MikyM0use/OLED-scanner/(threads)

Thread 1 (2016-09-19):

video out consistent through entire channel range

thedreygen, 2016-09-19:
Hi, I did this modification on my rc305 using all of the same hardware as you did. Thanks for your work and for the great info!

I am having an issue with my video output; it isn't coming through clearly. I have tried with both a 25mw and 200mw video transmitter and set the OLEDrx to the same channel, but the image is coming through like it isn't "locked" onto a channel. I'm thinking it may be stuck in scan mode and not changing to rx... not sure as I am not very great at arduino coding, but I am getting better :)

Unfortunately I do not have a DVR, but I snapped a few pictures of my quanums. I'd appreciate any help if you have a clue as to what may be going on.
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
PS - I know that I need to adjust the voltage divider but that isn't on the top of my list right now :)
Thanks!

Thread 2 (2017-06-10):

Battery calibration

andredavanz, 2017-06-10:
Hi! I've connected 1s battery tu a usb step-up converter to provide 5v to the circuit, but the battery voltage displayed is a little too high for my lipo (it shows 4,43V , it should be now around 4V). can you please add a method to "offset" the battery displayed voltage up and down a little? it would help me with this problem and it should be easy enough.

Thank you :)
