MikyM0use/OLED-scanner/src/oled_scanner_sketch/oled_scanner_sketch.ino

/*
This file is part of OLED 5.8ghz Scanner project.

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
    Copyright © 2016 Michele Martinelli
  */

#include <SPI.h>
#include <Wire.h>
#include <EEPROM.h>
#include "U8glib.h"
#include "rx5808.h"
#include "const.h"

// devices with all constructor calls is here: http://code.google.com/p/u8glib/wiki/device
U8GLIB_SSD1306_128X64 u8g(U8G_I2C_OPT_DEV_0 | U8G_I2C_OPT_NO_ACK | U8G_I2C_OPT_FAST); // Fast I2C / TWI

RX5808 rx5808(rssi_pin);

byte data0 = 0;
byte data1 = 0;
byte data2 = 0;
byte data3 = 0;

#define SCANNER_MODE 0
#define RECEIVER_MODE 1

uint8_t curr_status = SCANNER_MODE;
uint8_t curr_screen = 6;
uint8_t curr_channel = 0;
uint32_t curr_freq;

//battery monitor
float volt;
uint16_t VoltDivider = 10.5;

uint32_t last_irq;
uint8_t changing_freq, changing_mode;

//default values used for calibration
uint16_t rssi_min = 1024;
uint16_t rssi_max = 0;

void irq_select_handle() {
  if (millis() - last_irq < 500) //debounce
    return;

  if (curr_status == SCANNER_MODE && digitalRead(button_select) == LOW) { //simply switch to the next screen
    curr_screen = (curr_screen + 1) % 7;
  }

  if (curr_status == RECEIVER_MODE) {
    if (digitalRead(button_select) == HIGH && millis() - last_irq > 800) //long press to reach the next strong cannel
      curr_channel = rx5808.getNext(curr_channel);
    else
      curr_channel = (curr_channel + 1) % CHANNEL_MAX;

    changing_freq = 1;
  }

  rx5808.abortScan();
  last_irq = millis();
}

void irq_mode_handle() {
  if (millis() - last_irq < 500) //debounce
    return;

  if (digitalRead(button_mode) == LOW) {
    rx5808.abortScan();
    changing_mode = 1;

    if (curr_status == RECEIVER_MODE) {
      curr_status = SCANNER_MODE;
    } else {
      curr_status = RECEIVER_MODE;
      curr_channel = rx5808.getMaxPos(); //next channel is the strongest
    }
  }
  last_irq = millis();
}

void setup() {
  //button init
  pinMode(button_select, INPUT);
  digitalWrite(button_select, HIGH);
  pinMode(button_mode, INPUT);
  digitalWrite(button_mode, HIGH);

  //display init
  // assign default color value
  if ( u8g.getMode() == U8G_MODE_R3G3B2 ) {
    u8g.setColorIndex(255);     // white
  }
  else if ( u8g.getMode() == U8G_MODE_GRAY2BIT ) {
    u8g.setColorIndex(3);         // max intensity
  }
  else if ( u8g.getMode() == U8G_MODE_BW ) {
    u8g.setColorIndex(1);         // pixel on
  }
  else if ( u8g.getMode() == U8G_MODE_HICOLOR ) {
    u8g.setHiColorByRGB(255, 255, 255);
  }

  u8g.setDefaultForegroundColor();
  splashScr();

  // initialize SPI:
  pinMode (SSP, OUTPUT);
  SPI.begin();
  SPI.setBitOrder(LSBFIRST);
  rx5808.init();

  //power on calibration if button pressed
  while (digitalRead(button_select) == LOW || digitalRead(button_mode) == LOW) {
    rx5808.calibration();
  }

  //receiver init
  curr_channel = rx5808.getMaxPos();
  changing_freq = 1;
  changing_mode = 0;

  //rock&roll
  attachInterrupt(digitalPinToInterrupt(button_select), irq_select_handle, CHANGE);
  attachInterrupt(digitalPinToInterrupt(button_mode), irq_mode_handle, CHANGE);
}

void loop(void) {
  battery_measure();

  if (curr_status == SCANNER_MODE) {
    rx5808.scan(1, BIN_H);
  }

  u8g.firstPage();
  do {
    if (changing_mode) { //if changing mode "please wait..."
      wait_draw();
    } else {
      if (curr_status == RECEIVER_MODE) {
        receiver_draw(curr_channel);
      }
      if (curr_status == SCANNER_MODE) {
        scanner_draw(curr_screen);
      }
    }
  } while ( u8g.nextPage() );

  if (curr_status == RECEIVER_MODE && changing_freq || changing_mode) {
    changing_freq = changing_mode = 0;
    rx5808.scan(1, BIN_H);
    curr_freq = pgm_read_word_near(channelFreqTable + curr_channel);
    rx5808.setFreq(curr_freq);
  }
}
