MikyM0use/OLED-scanner/src/oled_scanner_sketch/rx5808.ino

/*
This file is part of OLED 5.8ghz Scanner project.

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
    Copyright © 2016 Michele Martinelli
  */

#include "rx5808.h"
#define RSSI_THRESH (scanVec[getMaxPos()]-5) //strong channels are near to the global max

RX5808::RX5808(uint16_t pin) {
  _rssiPin = pin;
  _stop_scan = 0;
}

uint16_t RX5808::getRssi(uint16_t channel) {
  return scanVec[channel];
}

//stop scan
void RX5808::abortScan(void) {
  _stop_scan = 1;
}
//get next strong rssi channel
uint16_t RX5808::getNext(uint16_t channel) {
  channel = (channel + 1) % CHANNEL_MAX;
  for (uint16_t  complete_iter = CHANNEL_MAX - CHANNEL_MIN; complete_iter != 0; complete_iter-- ) {
    if (scanVec[channel] > RSSI_THRESH) //new over threashold
      return channel;
    channel = (channel + 1) % CHANNEL_MAX;
  }

  return channel;
}

//get the rssi value of a certain channel of a band and map it to 1...norm
uint16_t RX5808::getVal(uint16_t band, uint16_t channel, uint8_t norm) {
  return map(scanVec[8 * band + channel], 1, 40, 1, norm);
}

//get the maximum rssi value for a certain band
uint16_t RX5808::getMaxPosBand(uint8_t band) {
  uint16_t _chan;
  uint16_t maxVal = 0, maxPos = 8 * band;
  for (_chan = 8 * band; _chan < 8 * band + 8; _chan++) {
    if (maxVal < scanVec[_chan]) { //new max
      maxPos = _chan;
      maxVal = scanVec[_chan];

    }
  }
  return maxPos;
}

//get the minimum rssi value for a certain band
uint16_t RX5808::getMinPosBand(uint8_t band) {
  uint16_t _chan;
  uint16_t minVal = 1000, minPos = 8 * band;
  for (_chan = 8 * band; _chan < 8 * band + 8; _chan++) {
    if (minVal > scanVec[_chan]) { //new max
      minPos = _chan;
      minVal = scanVec[_chan];

    }
  }
  return minPos;
}

//get global max
uint16_t RX5808::getMaxPos() {
  uint8_t _chan;
  uint16_t maxVal = 0, maxPos = 0;
  for (_chan = CHANNEL_MIN; _chan < CHANNEL_MAX; _chan++) {
    if (maxVal < scanVec[_chan]) { //new max
      maxPos = _chan;
      maxVal = scanVec[_chan];

    }
  }
  return maxPos;
}

//get global min
uint16_t RX5808::getMinPos() {
  uint8_t _chan;
  uint16_t minVal = 1000, minPos = 0;
  for (_chan = CHANNEL_MIN; _chan < CHANNEL_MAX; _chan++) {
    if (minVal > scanVec[_chan]) { //new max
      minPos = _chan;
      minVal = scanVec[_chan];

    }
  }
  return minPos;
}

void RX5808::init() {
  rssi_min = ((EEPROM.read(EEPROM_ADR_RSSI_MIN_H) << 8) | (EEPROM.read(EEPROM_ADR_RSSI_MIN_L)));
  rssi_max = ((EEPROM.read(EEPROM_ADR_RSSI_MAX_H) << 8) | (EEPROM.read(EEPROM_ADR_RSSI_MAX_L)));

  digitalWrite(SSP, LOW);
  SPI.transfer(0x10);
  SPI.transfer(0x01);
  SPI.transfer(0x00);
  SPI.transfer(0x00);
  digitalWrite(SSP, HIGH);

  rx5808.scan(1, BIN_H);
}

//set a certain frequency for the RX module
void RX5808::setFreq(uint32_t freq) {
  uint32_t Delitel = (freq - 479) / 2;

  byte DelitelH = Delitel >> 5;
  byte DelitelL = Delitel & 0x1F;

  data0 = DelitelL * 32 + 17;
  data1 = DelitelH * 16 + DelitelL / 8;
  data2 = DelitelH / 16;
  data3 = 0;

  digitalWrite(SSP, LOW);
  SPI.transfer(data0);
  SPI.transfer(data1);
  SPI.transfer(data2);
  SPI.transfer(data3);
  digitalWrite(SSP, HIGH);
}

//do a complete scan and normalize all the values
void RX5808::scan(uint16_t norm_min, uint16_t norm_max) {

  for (uint16_t _chan = CHANNEL_MIN; _chan < CHANNEL_MAX; _chan++) {
    if (_stop_scan) {
      _stop_scan = 0;
      return;
    }

    uint32_t freq = pgm_read_word_near(channelFreqTable + _chan);
    setFreq(freq);
    _wait_rssi();

    uint16_t rssi =  _readRSSI();
    rssi = constrain(rssi, rssi_min, rssi_max);
    rssi = map(rssi, rssi_min, rssi_max, norm_min, norm_max);   // scale from 1..100%
    scanVec[_chan] = rssi;
  }
}

//same as scan, but raw values, used for calibration
void RX5808::_calibrationScan() {
  for (uint16_t _chan = CHANNEL_MIN; _chan < CHANNEL_MAX; _chan++) {

    uint32_t freq = pgm_read_word_near(channelFreqTable + _chan);
    setFreq(freq);
    _wait_rssi();
    scanVec[_chan] = _readRSSI();
  }
}

void RX5808::_wait_rssi() {
  // 30ms will to do a 32 channels scan in 1 second
#define MIN_TUNE_TIME 30
  delay(MIN_TUNE_TIME);
}

uint16_t RX5808::_readRSSI() {
  uint32_t  sum = 0;
  for (uint8_t i = 0; i < 10; i++)
  {
    sum += analogRead(_rssiPin);
    delay(2);
  }
  return sum / 10; // average
}

//compute the min and max RSSI value and store the values in EEPROM
void RX5808::calibration() {
  int i = 0, j = 0;
  uint16_t  rssi_setup_min = 1024, minValue = 1024;
  uint16_t  rssi_setup_max = 0, maxValue = 0;

  for (j = 0; j < 5; j++) {
    _calibrationScan();

    for (i = CHANNEL_MIN; i < CHANNEL_MAX; i++) {
      uint16_t rssi = scanVec[i];

      minValue = min(minValue, rssi);
      maxValue = max(maxValue, rssi);
    }

    rssi_setup_min = min(rssi_setup_min, minValue); //?minValue:rssi_setup_min;
    rssi_setup_max = max(rssi_setup_max, maxValue); //?maxValue:rssi_setup_max;
  }

  // save 16 bit
  EEPROM.write(EEPROM_ADR_RSSI_MIN_L, (rssi_setup_min & 0xff));
  EEPROM.write(EEPROM_ADR_RSSI_MIN_H, (rssi_setup_min >> 8));
  // save 16 bit
  EEPROM.write(EEPROM_ADR_RSSI_MAX_L, (rssi_setup_max & 0xff));
  EEPROM.write(EEPROM_ADR_RSSI_MAX_H, (rssi_setup_max >> 8));

  rssi_min = ((EEPROM.read(EEPROM_ADR_RSSI_MIN_H) << 8) | (EEPROM.read(EEPROM_ADR_RSSI_MIN_L)));
  rssi_max = ((EEPROM.read(EEPROM_ADR_RSSI_MAX_H) << 8) | (EEPROM.read(EEPROM_ADR_RSSI_MAX_L)));

  //print the min and max value
  u8g.firstPage();
  do {

    sprintf (buf, "MIN: %d", rssi_setup_min);
    u8g.drawStr(20, 20, buf);

    sprintf (buf, "MAX: %d", rssi_setup_max);
    u8g.drawStr(20, 50, buf);

  } while ( u8g.nextPage() );

  delay(3000);

  return;
}
