MikyM0use/OLED-scanner/(commit log)

2016-01-03 solved delay-screen-switch bug
2016-01-03 deleted Arduino_fw
2016-01-03 coupling with images
2016-01-24 calibration section
2016-01-26 adding voltage source comment
